gom9000/TankYou-rev2/(list of files, drawings)

Other design files:
hardware/tank-you-r2.pcb
