gom9000/TankYou-rev2/(commit log)

2026-06-28 add circuit tests
2026-06-29 update circuit tests
